biokodein/drone-synth-version-3/syntak3/schematic-png.png

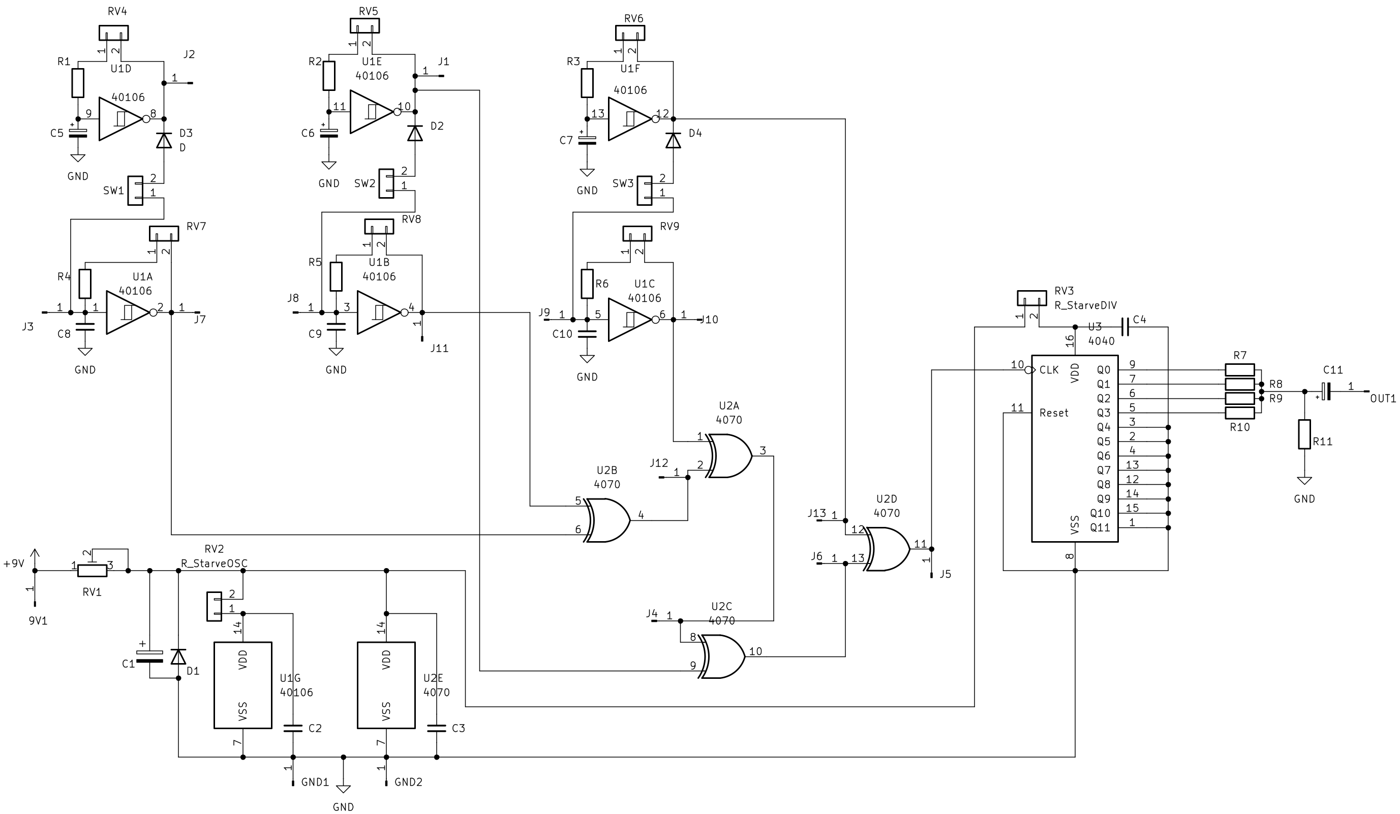
syntak3/schematic-png.png
