biokodein/drone-synth-version-3/syntak3/schematic.pdf

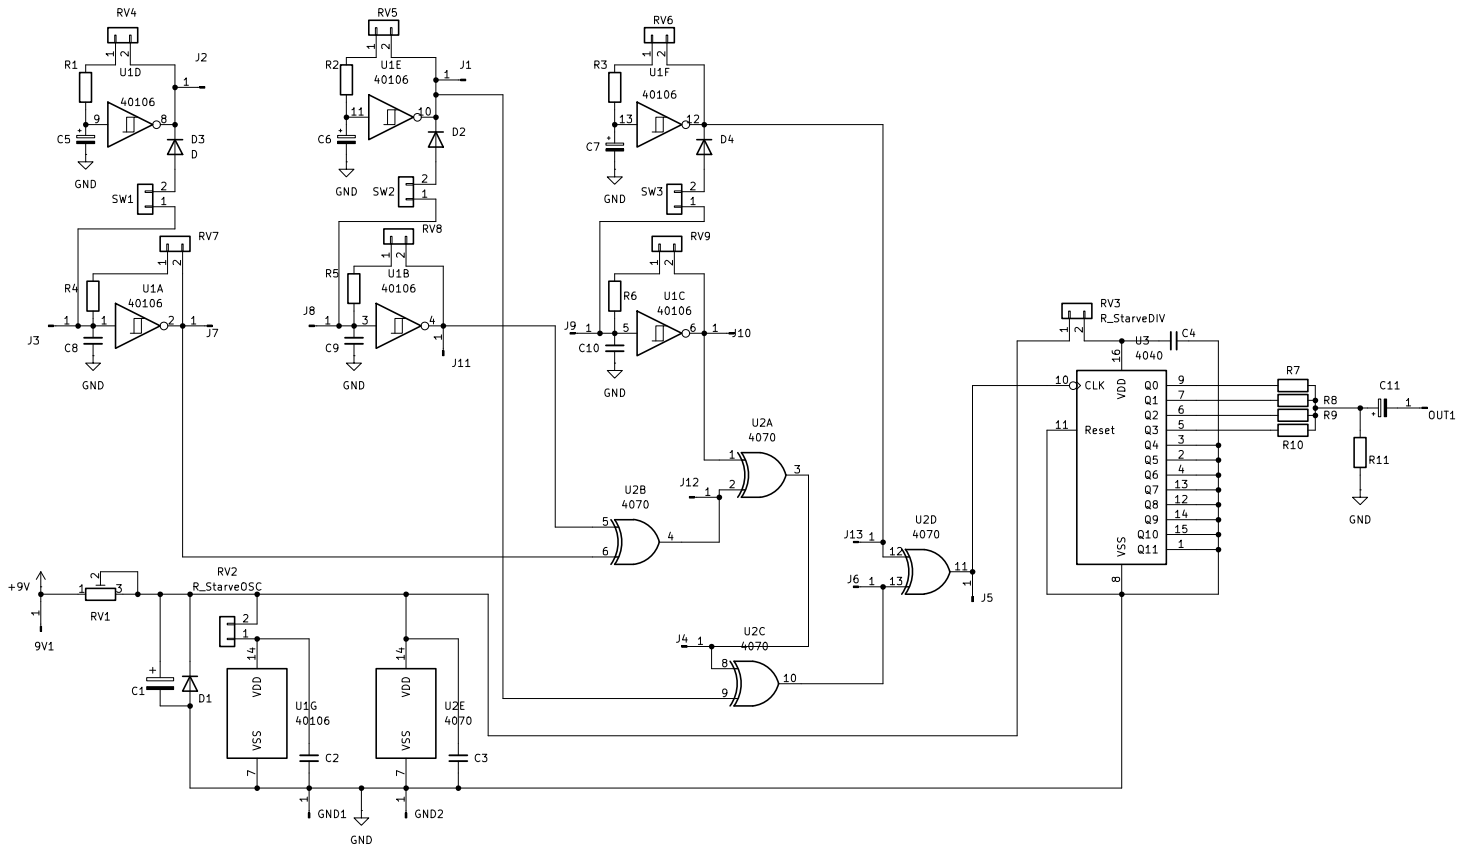
[picture p2: page 1]
