biokodein/drone-synth-version-3/syntak3/syntak3.kicad_pcb

## KiCad design syntak3/syntak3.kicad_pcb (2026-07-24)

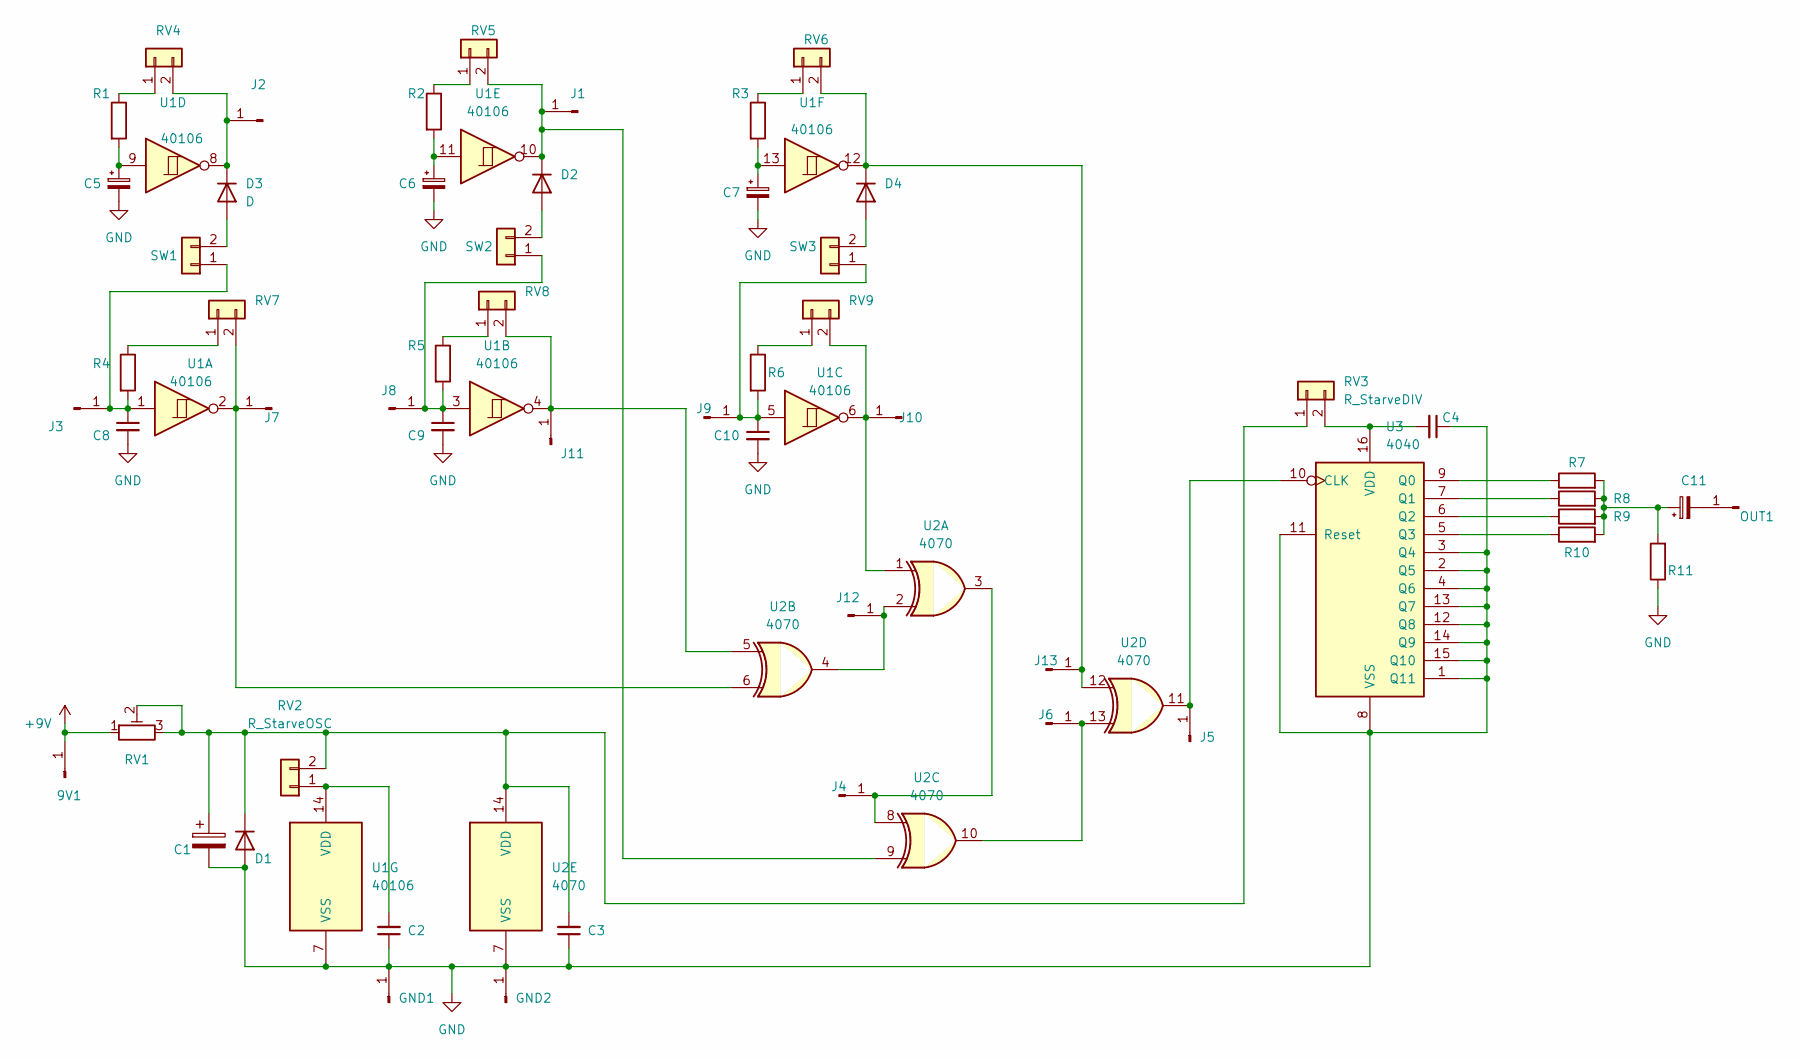
[picture p3: schematic syntak3.kicad_sch]

Parts:
9V1: Conn_01x01_Pin; SolderWire-0.5sqmm_1x01_D0.9mm_OD2.1mm
C1: C_Polarized; CP_Radial_D13.0mm_P5.00mm
C2, C3, C4, C8, C9, C10: C_Small; C_MLCC_D4.3mm_W1.9mm_P5.00mm
C5, C6, C7, C11: C_Polarized_Small; CP_Electro_Radial_D5.0mm_P2.50mm
D1, D2, D3, D4: D; DIODE_DO-35_SOD27_P7.62mm_Horizontal
GND1, GND2: Conn_01x01_Pin; SolderWire-0.5sqmm_1x01_D0.9mm_OD2.1mm
J1, J2, J3, J4, J5, J6, J7, J8, J9, J10, J11, J12, J13: Conn_01x01_Pin; SolderWire-0.5sqmm_1x01_D0.9mm_OD2.1mm
OUT1: Conn_01x01_Pin; SolderWire-0.5sqmm_1x01_D0.9mm_OD2.1mm
R1, R2, R3, R4, R5, R6, R7, R8, R9, R10, R11: R; RES_0.25watt_L3.6mm_D1.6mm_P7.62mm_Horizontal
RV1: R_Potentiometer_Trim; Potentiometer_Runtron_RM-065_Vertical
RV2: R_StarveOSC; RV-cermet; Part Number 1-0201FBV0T
RV3: R_StarveDIV; RV-cermet; Part Number 1-0201FBV0T
RV4, RV5, RV6, RV7, RV8, RV9: R_Potentiometer; RV-cermet; Part Number 1-0201FBV0T
SW1, SW2, SW3: Socket_01x02; CONN_1x02_P2.54mm_Vertical; Part Number ?
U1: 40106; DIP-14_W7.62mm_Socket_LongPads
U2: 4070; DIP-14_W7.62mm_Socket_LongPads
U3: 4040; DIP-16_W7.62mm_Socket_LongPads

Connections:
+9V: 9V1.1, RV1.1; also elsewhere on the board
GND: C1.2, C2.1, C3.1, C4.1, C5.2, C6.2, C7.2, C8.2, C9.2, C10.2, D1.2 (A), GND1.1, GND2.1, R11.1, U1.7 (VSS), U2.7 (VSS), U3.1 (Q11), U3.2 (Q5), U3.3 (Q4), U3.4 (Q6), U3.8 (VSS), U3.11 (Reset), U3.12 (Q8), U3.13 (Q7), U3.14 (Q9), U3.15 (Q10); also elsewhere on the board
unnamed 2: C5.1, R1.2, U1.9; also elsewhere on the board
unnamed 3: C6.1, R2.2, U1.11; also elsewhere on the board
unnamed 4: C7.1, R3.2, U1.13; also elsewhere on the board
unnamed: C11.1, R7.2, R8.2, R9.2, R10.2, R11.2
unnamed 6: C1.1, C3.2, D1.1 (K), RV1.2, RV1.3, RV2.2, RV3.1, U2.14 (VDD); also elsewhere on the board
unnamed: D2.2 (A), SW2.2
unnamed 8: D2.1 (K), J1.1, RV5.2, U1.10, U2.9; also elsewhere on the board
unnamed: D3.2 (A), SW1.2
unnamed 10: D3.1 (K), J2.1, RV4.2, U1.8; also elsewhere on the board
unnamed: D4.2 (A), SW3.2
unnamed 12: D4.1 (K), J13.1, RV6.2, U1.12, U2.12; also elsewhere on the board
unnamed 13: C8.1, J3.1, R4.2, SW1.1, U1.1; also elsewhere on the board
unnamed 14: J4.1, U2.3, U2.8; also elsewhere on the board
unnamed 15: J5.1, U2.11, U3.10 (CLK); also elsewhere on the board
unnamed 16: J6.1, U2.10, U2.13; also elsewhere on the board
unnamed 17: J7.1, RV7.2, U1.2, U2.6; also elsewhere on the board
unnamed 18: C9.1, J8.1, R5.2, SW2.1, U1.3; also elsewhere on the board
unnamed 19: C10.1, J9.1, R6.2, SW3.1, U1.5; also elsewhere on the board
unnamed 20: J10.1, RV9.2, U1.6, U2.1; also elsewhere on the board
unnamed 21: J11.1, RV8.2, U1.4, U2.5; also elsewhere on the board
unnamed 22: J12.1, U2.2, U2.4; also elsewhere on the board
unnamed: C11.2, OUT1.1
unnamed 24: C2.2, RV2.1, U1.14 (VDD); also elsewhere on the board
unnamed 25: C4.2, RV3.2, U3.16 (VDD); also elsewhere on the board
unnamed: R1.1, RV4.1
unnamed: R2.1, RV5.1
unnamed: R3.1, RV6.1
unnamed: R4.1, RV7.1
unnamed: R5.1, RV8.1
unnamed: R6.1, RV9.1
unnamed 32: R7.1, U3.9 (Q0); also elsewhere on the board
unnamed 33: R8.1, U3.7 (Q1); also elsewhere on the board
unnamed 34: R9.1, U3.6 (Q2); also elsewhere on the board
unnamed 35: R10.1, U3.5 (Q3); also elsewhere on the board

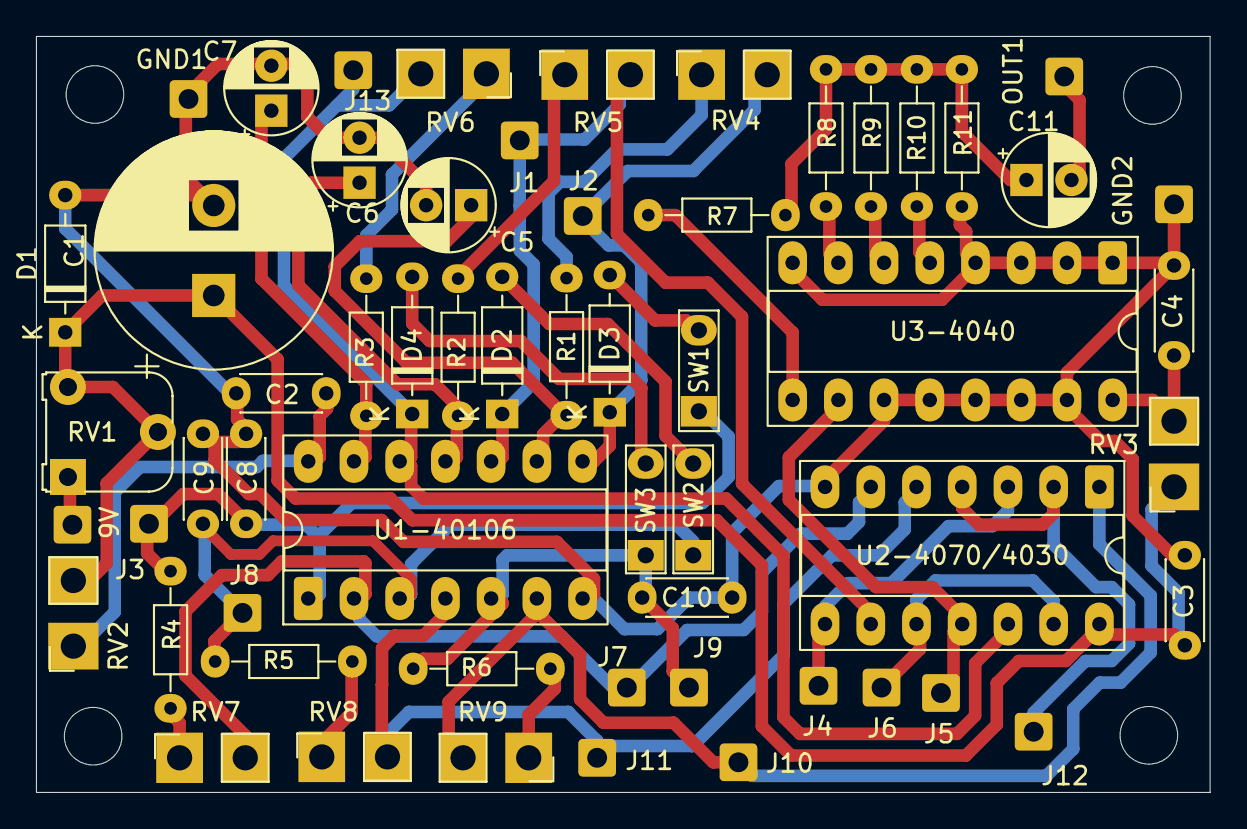
[picture p4: board syntak3.kicad_pcb from above]

Board: 2 copper layers, 65.2 x 42.0 mm, 58 parts (0 on the bottom side), 36 nets.

Other parts of the board:
9V: Conn_01x01_Pin; SolderWire-0.5sqmm_1x01_D0.9mm_OD2.1mm
U1-40106: 40106; DIP-14_W7.62mm_Socket_LongPads
U2-4070/4030: 4070; DIP-14_W7.62mm_Socket_LongPads
U3-4040: 4040; DIP-16_W7.62mm_Socket_LongPads

Their connections:
+9V: 9V.1; also elsewhere on the board
GND: U1-40106.7 (VSS), U2-4070/4030.7 (VSS), U3-4040.1 (Q11), U3-4040.2 (Q5), U3-4040.3 (Q4), U3-4040.4 (Q6), U3-4040.8 (VSS), U3-4040.11 (Reset), U3-4040.12 (Q8), U3-4040.13 (Q7), U3-4040.14 (Q9), U3-4040.15 (Q10); also elsewhere on the board
unnamed 2: U1-40106.9; also elsewhere on the board
unnamed 3: U1-40106.11; also elsewhere on the board
unnamed 4: U1-40106.13; also elsewhere on the board
unnamed 6: U2-4070/4030.14 (VDD); also elsewhere on the board
unnamed 8: U1-40106.10, U2-4070/4030.9; also elsewhere on the board
unnamed 10: U1-40106.8; also elsewhere on the board
unnamed 12: U1-40106.12, U2-4070/4030.12; also elsewhere on the board
unnamed 13: U1-40106.1; also elsewhere on the board
unnamed 14: U2-4070/4030.3, U2-4070/4030.8; also elsewhere on the board
unnamed 15: U2-4070/4030.11, U3-4040.10 (CLK); also elsewhere on the board
unnamed 16: U2-4070/4030.10, U2-4070/4030.13; also elsewhere on the board
unnamed 17: U1-40106.2, U2-4070/4030.6; also elsewhere on the board
unnamed 18: U1-40106.3; also elsewhere on the board
unnamed 19: U1-40106.5; also elsewhere on the board
unnamed 20: U1-40106.6, U2-4070/4030.1; also elsewhere on the board
unnamed 21: U1-40106.4, U2-4070/4030.5; also elsewhere on the board
unnamed 22: U2-4070/4030.2, U2-4070/4030.4; also elsewhere on the board
unnamed 24: U1-40106.14 (VDD); also elsewhere on the board
unnamed 25: U3-4040.16 (VDD); also elsewhere on the board
unnamed 32: U3-4040.9 (Q0); also elsewhere on the board
unnamed 33: U3-4040.7 (Q1); also elsewhere on the board
unnamed 34: U3-4040.6 (Q2); also elsewhere on the board
unnamed 35: U3-4040.5 (Q3); also elsewhere on the board
